inaxeon/dacattac/hardware/alpha/dacattac-alpha.xlsx

Qty | Reference(s) | Value | Footprint | Mouser part order number
34 | C1, C2, C3, C4, C5, C6, C7, C12, C13, C14, C15, C16, C17, C21, C22, C23, C43, C44, C45, C54, C57, C58, C59, C67, C71, C72, C73, C74, C75, C76, C77, C78, C87, C88 | 100n | Capacitor_SMD:C_0603_1608Metric
3 | C8, C37, C69 | NF | Capacitor_SMD:C_0603_1608Metric
3 | C9, C19, C33 | 82p | Capacitor_SMD:C_0603_1608Metric
7 | C10, C18, C20, C29, C30, C31, C40 | 100p | Capacitor_SMD:C_0603_1608Metric
3 | C11, C84, C85 | 33u | Capacitor_SMD:C_1210_3225Metric | C3225X5R1A336M200AC
2 | C24, C28 | 1n | Capacitor_SMD:C_0603_1608Metric
3 | C25, C39, C50 | 560p | Capacitor_SMD:C_0603_1608Metric
1 | C26 | 680p | Capacitor_SMD:C_0603_1608Metric
3 | C27, C51, C52 | 2n2 | Capacitor_SMD:C_0603_1608Metric
3 | C32, C36, C42 | 220p | Capacitor_SMD:C_0603_1608Metric
1 | C34 | 56p | Capacitor_SMD:C_0603_1608Metric
2 | C35, C47 | 390p | Capacitor_SMD:C_0603_1608Metric
1 | C38 | 270p | Capacitor_SMD:C_0603_1608Metric
1 | C41 | 18p | Capacitor_SMD:C_0603_1608Metric
1 | C46 | 47p | Capacitor_SMD:C_0603_1608Metric
1 | C48 | 4p7 | Capacitor_SMD:C_0603_1608Metric
1 | C49 | 2p-18p | BFC2808xxxxx:BFC2808xxxxx | BFC280811229
4 | C53, C56, C60, C61 | 2u2 | Capacitor_SMD:C_0603_1608Metric
1 | C55 | 10uF | Capacitor_SMD:C_1210_3225Metric | C3225X5R1E106K250AA
1 | C62 | 10n | Capacitor_SMD:C_0603_1608Metric
2 | C63, C68 | 10u | Capacitor_SMD:C_1210_3225Metric | C3225X7R1E106K250AC
1 | C64 | 4.7u | Capacitor_SMD:C_1210_3225Metric | C3225X7R1H475K250AB
1 | C65 | 4n7 | Capacitor_SMD:C_0603_1608Metric
1 | C66 | 220n | Capacitor_SMD:C_0603_1608Metric
1 | C70 | 180p | Capacitor_SMD:C_0603_1608Metric
1 | C79 | 22u | Capacitor_SMD:C_1210_3225Metric | C3225X7R1C226M250AC
2 | D1, D2 | MBR0540T1 | Diode_SMD:D_SOD-123 | MBR0540T1G
4 | D3, D4, D5, D6 | 1N4148 | Diode_SMD:D_SOD-123 | 1N4148W-7-F
1 | J1 | EXT POWER | Connector_Molex:Molex_KK-254_AE-6410-03A_1x03_P2.54mm_Vertical
2 | J2, J3 | OUT | MOLEX_73101:731010120 | 731010120
1 | J4 | AUDIO OUT | PJRAN2X1U01X:PJRAN2X1U01X | PJRAN2X1U01X
1 | J6 | I2C | Connector_Molex:Molex_KK-254_AE-6410-05A_1x05_P2.54mm_Vertical
6 | J10, J11, J12, J13, J14, J15 | HOLE | hackrf:GSG-HOLE126MIL-COPPER
1 | JP1 | TEST | Connector_PinHeader_2.54mm:PinHeader_1x03_P2.54mm_Vertical
6 | L5, L6, L17, L18, L21, L22 | 5u6 | Inductor_SMD:L_1210_3225Metric | 7440450056
1 | L7 | 9510 | NEOSID_7MM:NEOSID_7MM
1 | L8 | 9770 | NEOSID_7MM:NEOSID_7MM
2 | L9, L10 | 9760 | NEOSID_7MM:NEOSID_7MM
3 | L11, L12, L13 | 9750 | NEOSID_7MM:NEOSID_7MM
1 | L14 | 9500 | NEOSID_7MM:NEOSID_7MM
1 | L15 | 10u | Inductor_SMD:L_1210_3225Metric | 744045100
1 | L16 | 4u7 | Inductor_SMD:L_1210_3225Metric | 7440329004
1 | P20 | P20 | hackrf:GSG-HEADER-2x11
1 | P22 | P22 | hackrf:GSG-HEADER-2x13
1 | P28 | P28 | hackrf:GSG-HEADER-2x11
1 | P30 | BANK2_AUX | hackrf:GSG-HEADER-2x10
2 | Q1, Q2 | 2N7002 | Package_TO_SOT_SMD:SOT-23 | 2N7002
1 | Q3 | IRLML2244 | Package_TO_SOT_SMD:SOT-23 | IRLML2244TRPBF
2 | Q4, Q5 | BC857 | Package_TO_SOT_SMD:SOT-23 | BC857BS,135
1 | Q6 | BC807 | Package_TO_SOT_SMD:SOT-23 | BC807-40,215
2 | R1, R9 | 33 | Resistor_SMD:R_0603_1608Metric
1 | R2 | 3k9 | Resistor_SMD:R_0603_1608Metric
4 | R3, R52, R39, R32 | 10k | Resistor_SMD:R_0603_1608Metric
6 | R4, R13, R14, R15, R16, R28 | 100 | Resistor_SMD:R_0603_1608Metric
2 | R5, R25 | 3k3 | Resistor_SMD:R_0603_1608Metric
1 | R33 | 6k98 | Resistor_SMD:R_0603_1608Metric | RC0603FR-076K98L
1 | R45 | 10 | Resistor_SMD:R_0603_1608Metric
1 | R42 | 150k | Resistor_SMD:R_0603_1608Metric
1 | R41 | 988k | Resistor_SMD:R_0603_1608Metric | RN73H1JTTD9883F50
1 | R38 | 55k6 | Resistor_SMD:R_0603_1608Metric | TNPW060355K6BEEA
3 | R7, R11, R27 | 330 | Resistor_SMD:R_0603_1608Metric
4 | R8, R29, R30, R49 | 470 | Resistor_SMD:R_0603_1608Metric
3 | R10, R17, R51 | 75 | Resistor_SMD:R_0603_1608Metric
1 | R12 | 68 | Resistor_SMD:R_0603_1608Metric
3 | R6, R18, R36 | NF | Resistor_SMD:R_0603_1608Metric
1 | R19 | 1k8 | Resistor_SMD:R_0603_1608Metric
1 | R20 | 4k7 | Resistor_SMD:R_0603_1608Metric
2 | R21, R43 | 1k | Resistor_SMD:R_0603_1608Metric
3 | R22, R61, R62 | 2k2 | Resistor_SMD:R_0603_1608Metric
1 | R23 | 10 | Resistor_SMD:R_0603_1608Metric
1 | R24 | 270 | Resistor_SMD:R_0603_1608Metric
1 | R26 | 180 | Resistor_SMD:R_0603_1608Metric
1 | R31 | 220 | Resistor_SMD:R_0603_1608Metric
4 | R34, R35, R37, R46 | 0 | Resistor_SMD:R_0603_1608Metric
1 | R40 | 4k99 | Resistor_SMD:R_0603_1608Metric | RC0603FR-134K99L
1 | R44 | 1k5 | Resistor_SMD:R_0603_1608Metric
1 | R47 | 4k3 | Resistor_SMD:R_0603_1608Metric
1 | R48 | 47 | Resistor_SMD:R_0603_1608Metric
1 | R50 | 909 | Resistor_SMD:R_0603_1608Metric | RC0603FR-13909RL
1 | U1 | 74LVCH16T245 | Package_SO:TSSOP-48_6.1x12.5mm_P0.5mm | SN74LVCH16T245DGGR
1 | U2 | TPS61170DRVR | TPS61170DRVR:SON65P200X200X80-7N | TPS61170DRVR
1 | U3 | 74LVC1T45 | Package_TO_SOT_SMD:SOT-23-6 | SN74LVC1T45DBVT
1 | U4 | AD768 | Package_SO:SOIC-28W_7.5x18.7mm_P1.27mm | AD768ARZ
2 | U5, U7 | MAX4104 | Package_TO_SOT_SMD:SOT-23-5 | MAX4104EUK+T
1 | U6 | TLE2082 | Package_SO:SOIC-8_3.9x4.9mm_P1.27mm | TLE2082IDR
1 | U9 | PCM5102 | Package_SO:TSSOP-20_4.4x6.5mm_P0.65mm | PCM5102APW
1 | U10 | MCP1700T-3302E/MB | Package_TO_SOT_SMD:SOT-89-3 | MCP1700T-3302E/MB
1 | U11 | TPS63700DRCT | TPS63700DRCT:VREG_V62_16624-01YE | TPS63700DRCT
1 | U13 | L78L05_SO8 | Package_SO:SOIC-8_3.9x4.9mm_P1.27mm | L78L05ACD13TR
1 | U14 | L79L05_SO8 | Package_SO:SOIC-8_3.9x4.9mm_P1.27mm | L79L05ACD13TR
1 | U17 | MCP47FEB22A0-E/ST | Package_SO:TSSOP-8_4.4x3mm_P0.65mm | MCP47FEB22A0-E/ST
1 |  |  | HackRF One BANK2_AUX header
