inaxeon/dacattac/hardware/alpha/thirdparty-syms/TPS63700DRCT.step

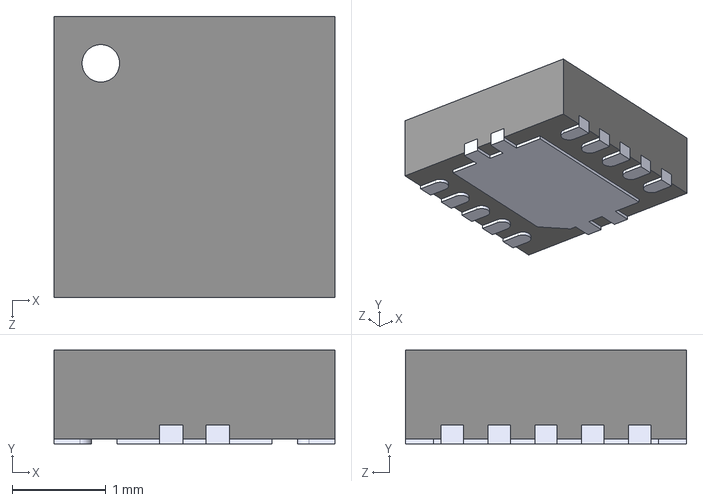
[picture p1: CAD file, 2024-06-18]
hardware/alpha/thirdparty-syms/TPS63700DRCT.step
3.00 x 1.00 x 3.00 mm
