inaxeon/dacattac/hardware/alpha/thirdparty-syms/TPS61170DRVR.step

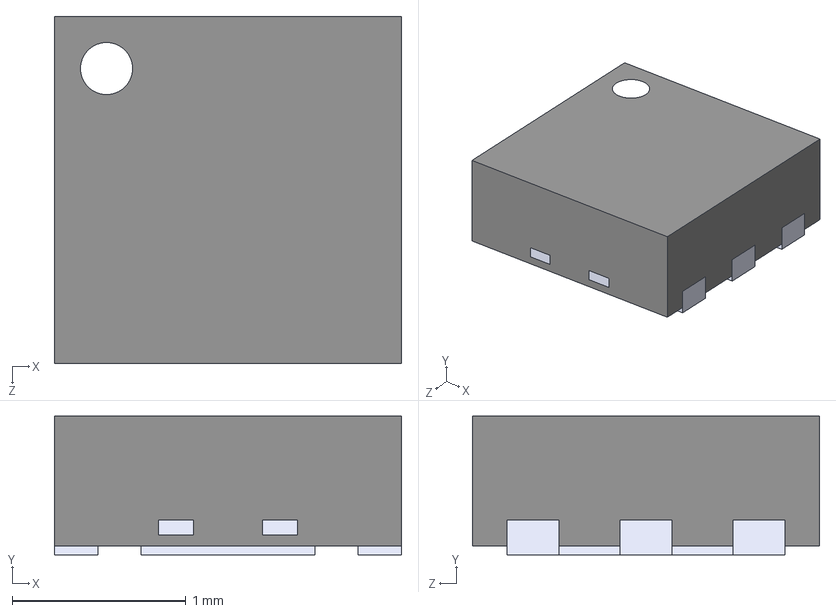
[picture p2: CAD file, 2024-06-13]
hardware/alpha/thirdparty-syms/TPS61170DRVR.step
2.00 x 0.8 x 2.00 mm
