inaxeon/dacattac/hardware/alpha/dacattac-alpha.kicad_pcb

## KiCad design hardware/alpha/dacattac-alpha.kicad_pcb (2024-10-24)

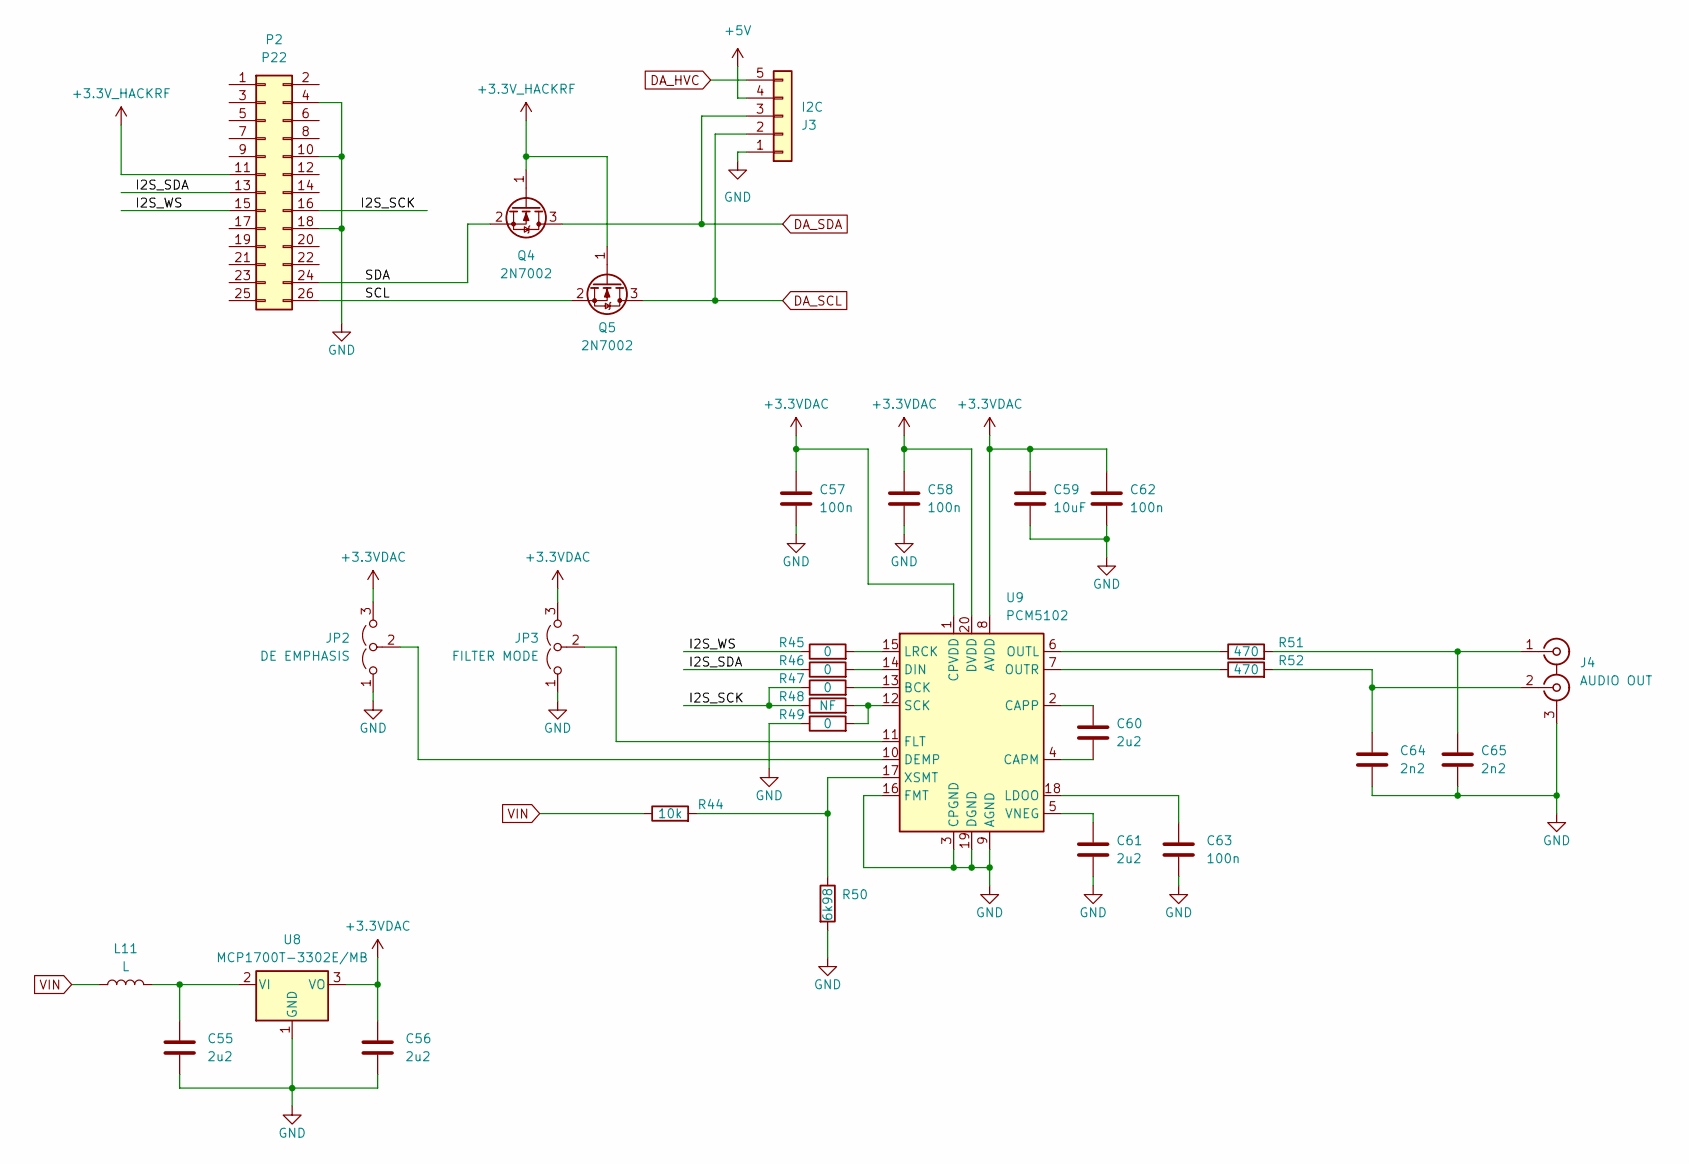
[picture p3: schematic audio.kicad_sch, ${TITLE}]

Parts:
C55, C56, C60, C61: 2u2; C_0603_1608Metric
C57, C58, C62, C63: 100n; C_0603_1608Metric
C59: 10uF; C_1210_3225Metric
C64, C65: 2n2; C_0603_1608Metric
J3: I2C; Molex_KK-254_AE-6410-05A_1x05_P2.54mm_Vertical
J4: AUDIO OUT; PJRAN2X1U01X
JP2: DE EMPHASIS; SolderJumper-3_P1.3mm_Open_Pad1.0x1.5mm
JP3: FILTER MODE; SolderJumper-3_P1.3mm_Open_Pad1.0x1.5mm
L11: L; L_1210_3225Metric
P2: P22; GSG-HEADER-2x13
Q4, Q5: 2N7002; SOT-23
R44: 10k; R_0603_1608Metric
R45, R46, R47, R49: 0; R_0603_1608Metric
R48: NF; R_0603_1608Metric
R50: 6k98; R_0603_1608Metric
R51, R52: 470; R_0603_1608Metric
U8: MCP1700T-3302E/MB; SOT-89-3
U9: PCM5102; TSSOP-20_4.4x6.5mm_P0.65mm

Connections:
+3.3VDAC: C56.1, C57.1, C58.1, C59.1, C62.1, JP2.3 (B), JP3.3 (B), U8.3 (VO), U9.1 (CPVDD), U9.8 (AVDD), U9.20 (DVDD)
+3.3V_HACKRF: P2.11, Q4.1 (G), Q5.1 (G); also elsewhere on the board
+5V: J3.4; also elsewhere on the board
/audio/I2S_SCK: P2.16, R47.1, R48.1
/audio/I2S_SDA: P2.13, R46.1
/audio/I2S_WS: P2.15, R45.1
/audio/SCL: P2.26, Q5.2 (S)
/audio/SDA: P2.24, Q4.2 (S)
DA_HVC: J3.5; also elsewhere on the board
DA_SCL: J3.2, Q5.3 (D); also elsewhere on the board
DA_SDA: J3.3, Q4.3 (D); also elsewhere on the board
GND: C55.2, C56.2, C57.2, C58.2, C59.2, C61.2, C62.2, C63.2, C64.2, C65.2, J3.1, J4.3 (EXT), JP2.1 (A), JP3.1 (A), P2.4, P2.10, P2.18, R49.1, R50.2, U8.1 (GND), U9.3 (CPGND), U9.9 (AGND), U9.16 (FMT), U9.19 (DGND); also elsewhere on the board
unnamed: C65.1, J4.1 (IN1), R51.2
unnamed: C64.1, J4.2 (IN2), R52.2
unnamed: JP2.2 (C), U9.10 (DEMP)
unnamed: JP3.2 (C), U9.11 (FLT)
unnamed: C55.1, L11.2, U8.2 (VI)
unnamed: R47.2, U9.13 (BCK)
unnamed: C60.2, U9.4 (CAPM)
unnamed: C60.1, U9.2 (CAPP)
unnamed: R46.2, U9.14 (DIN)
unnamed: C63.1, U9.18 (LDOO)
unnamed: R45.2, U9.15 (LRCK)
unnamed: R51.1, U9.6 (OUTL)
unnamed: R52.1, U9.7 (OUTR)
unnamed: R48.2, R49.2, U9.12 (SCK)
unnamed: C61.1, U9.5 (VNEG)
unnamed: R44.2, R50.1, U9.17 (XSMT)
VIN: L11.1, R44.1; also elsewhere on the board

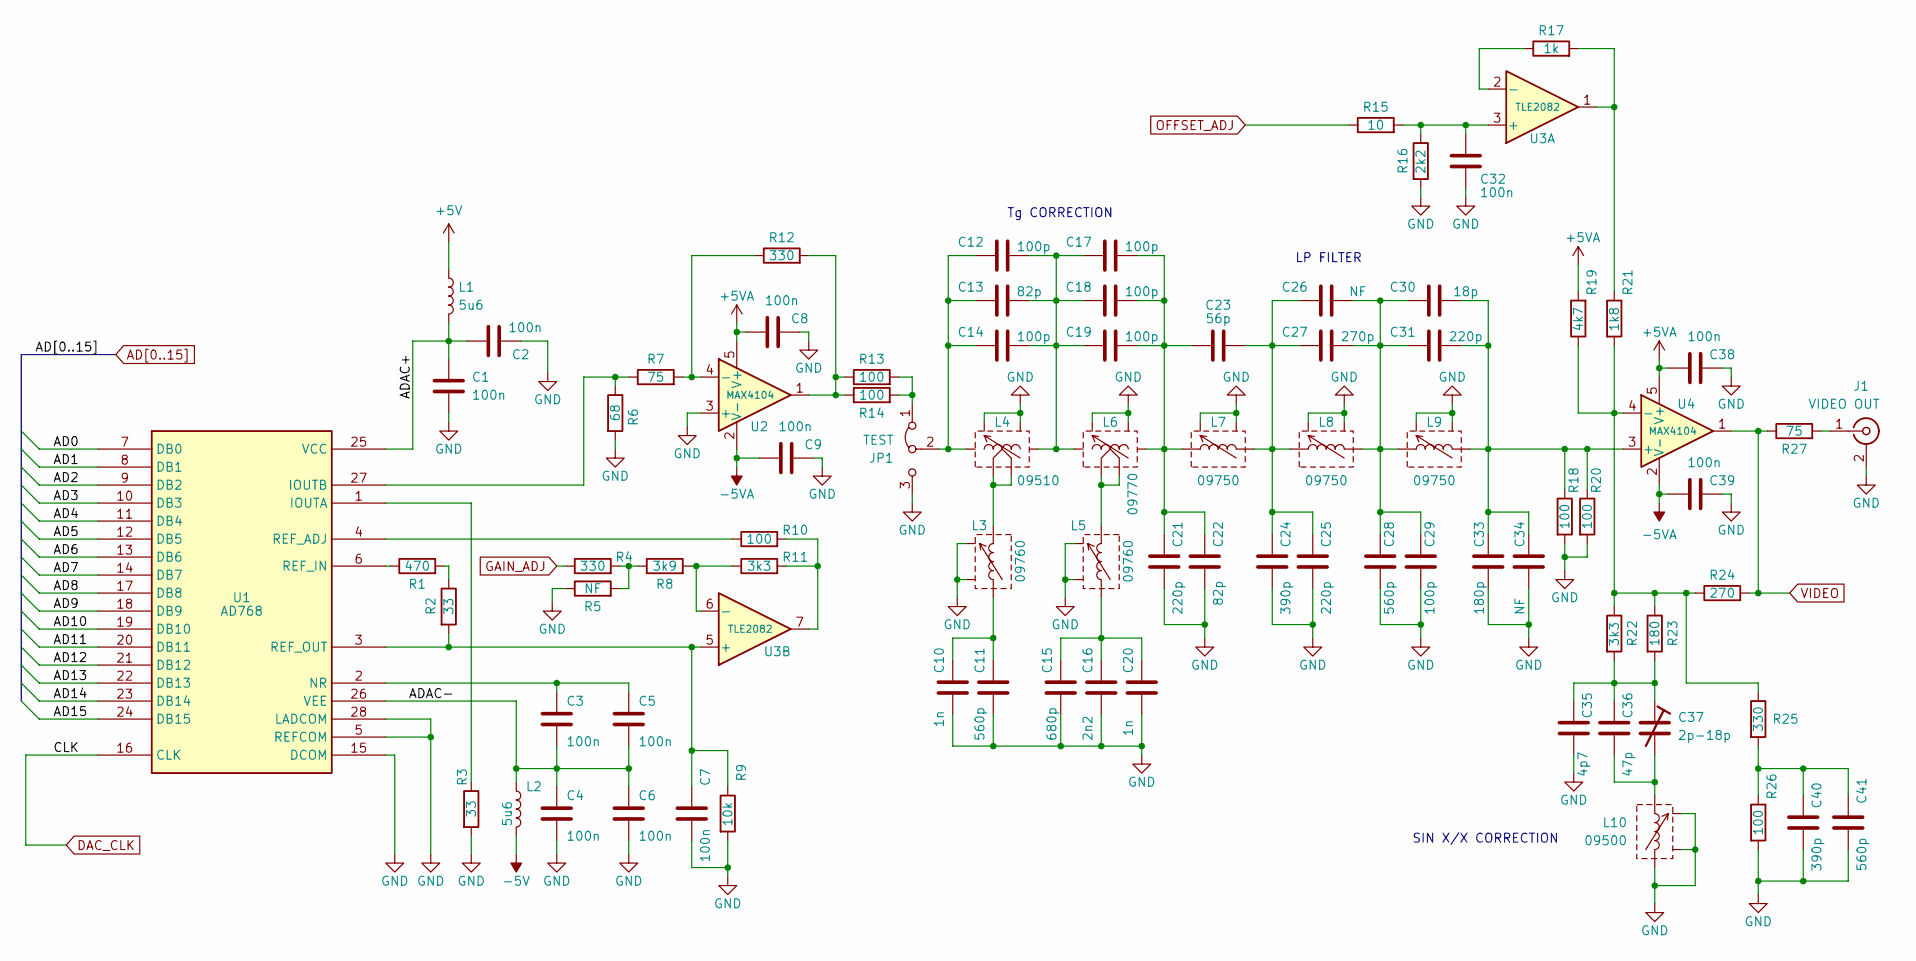
[picture p4: schematic video.kicad_sch, ${TITLE}]

Parts:
C1, C2, C3, C4, C5, C6, C7, C8, C9, C32, C38, C39: 100n; C_0603_1608Metric
C10, C20: 1n; C_0603_1608Metric
C11, C28, C41: 560p; C_0603_1608Metric
C12, C14, C17, C18, C19, C29: 100p; C_0603_1608Metric
C13, C22: 82p; C_0603_1608Metric
C15: 680p; C_0603_1608Metric
C16: 2n2; C_0603_1608Metric
C21, C25, C31: 220p; C_0603_1608Metric
C23: 56p; C_0603_1608Metric
C24, C40: 390p; C_0603_1608Metric
C26, C34: NF; C_0603_1608Metric
C27: 270p; C_0603_1608Metric
C30: 18p; C_0603_1608Metric
C33: 180p; C_0603_1608Metric
C35: 4p7; C_0603_1608Metric
C36: 47p; C_0603_1608Metric
C37: 2p-18p; BFC2808xxxxx
J1: VIDEO OUT; 731010120
JP1: TEST; PinHeader_1x03_P2.54mm_Vertical
L1, L2: 5u6; L_1210_3225Metric
L3, L5: 09760; NEOSID_7MM
L4: 09510; NEOSID_7MM
L6: 09770; NEOSID_7MM
L7, L8, L9: 09750; NEOSID_7MM
L10: 09500; NEOSID_7MM
R1: 470; R_0603_1608Metric
R2, R3: 33; R_0603_1608Metric
R4, R12, R25: 330; R_0603_1608Metric
R5: NF; R_0603_1608Metric
R6: 68; R_0603_1608Metric
R7, R27: 75; R_0603_1608Metric
R8: 3k9; R_0603_1608Metric
R9: 10k; R_0603_1608Metric
R10, R13, R14, R18, R20, R26: 100; R_0603_1608Metric
R11, R22: 3k3; R_0603_1608Metric
R15: 10; R_0603_1608Metric
R16: 2k2; R_0603_1608Metric
R17: 1k; R_0603_1608Metric
R19: 4k7; R_0603_1608Metric
R21: 1k8; R_0603_1608Metric
R23: 180; R_0603_1608Metric
R24: 270; R_0603_1608Metric
U1: AD768; SOIC-28W_7.5x18.7mm_P1.27mm
U2, U4: MAX4104; SOT-23-5
U3: TLE2082; SOIC-8_3.9x4.9mm_P1.27mm

Connections:
+5V: L1.1; also elsewhere on the board
+5VA: C8.1, C38.1, R19.2, U2.5 (V+), U4.5 (V+); also elsewhere on the board
-5V: L2.2; also elsewhere on the board
-5VA: C9.1, C39.1, U2.2 (V-), U4.2 (V-); also elsewhere on the board
/video/ADAC+: C1.2, C2.2, L1.2, U1.25 (VCC)
/video/ADAC-: C3.2, C4.1, C5.1, C6.1, L2.1, U1.26 (VEE)
AD0: U1.7 (DB0); also elsewhere on the board
AD1: U1.8 (DB1); also elsewhere on the board
AD2: U1.9 (DB2); also elsewhere on the board
AD3: U1.10 (DB3); also elsewhere on the board
AD4: U1.11 (DB4); also elsewhere on the board
AD5: U1.12 (DB5); also elsewhere on the board
AD6: U1.13 (DB6); also elsewhere on the board
AD7: U1.14 (DB7); also elsewhere on the board
AD8: U1.17 (DB8); also elsewhere on the board
AD9: U1.18 (DB9); also elsewhere on the board
AD10: U1.19 (DB10); also elsewhere on the board
AD11: U1.20 (DB11); also elsewhere on the board
AD12: U1.21 (DB12); also elsewhere on the board
AD13: U1.22 (DB13); also elsewhere on the board
AD14: U1.23 (DB14); also elsewhere on the board
AD15: U1.24 (DB15); also elsewhere on the board
DAC_CLK: U1.16 (CLK); also elsewhere on the board
GAIN_ADJ: R4.1; also elsewhere on the board
GND: C1.1, C2.1, C4.2, C6.2, C7.2, C8.2, C9.2, C10.2, C11.2, C15.2, C16.2, C20.2, C21.2, C22.2, C24.2, C25.2, C28.2, C29.2, C32.2, C33.2, C34.2, C35.2, C38.2, C39.2, C40.2, C41.2, J1.2 (Ext), JP1.3 (B), L3.6, L4.6, L5.6, L6.6, L7.6, L8.6, L9.6, L10.4, L10.6, R3.2, R5.1, R6.2, R9.2, R16.2, R18.2, R20.2, R26.2, U1.5 (REFCOM), U1.15 (DCOM), U1.28 (LADCOM), U2.3 (+); also elsewhere on the board
unnamed: C10.1, C11.1, L3.4
unnamed: C12.2, C13.2, C14.2, C17.1, C18.1, C19.1, L4.1, L6.5
unnamed: C15.1, C16.1, C20.1, L5.4
unnamed: C17.2, C18.2, C19.2, C21.1, C22.1, C23.1, L6.1, L7.1
unnamed: C23.2, C24.1, C25.1, C26.1, C27.1, L7.4, L8.1
unnamed: C26.2, C27.2, C28.1, C29.1, C30.1, C31.1, L8.4, L9.1
unnamed: C35.1, C36.1, C37.1, R22.2, R23.2
unnamed: C36.2, C37.2, L10.1
unnamed: C40.1, C41.1, R25.2, R26.1
unnamed: J1.1 (In), R27.2
unnamed: JP1.1 (A), R13.2, R14.2
unnamed: C12.1, C13.1, C14.1, JP1.2 (C), L4.5
unnamed: L3.1, L4.2, L4.4
unnamed: L5.1, L6.2, L6.4
unnamed: R1.2, R2.1
unnamed: R4.2, R5.2, R8.1
unnamed: R10.2, R11.2, U3.7
unnamed: R12.2, R13.1, R14.1, U2.1
unnamed: R17.2, R21.1, U3.1
unnamed: R3.1, U1.1 (IOUTA)
unnamed: R6.1, R7.1, U1.27 (IOUTB)
unnamed: C3.1, C5.2, U1.2 (NR)
unnamed: R10.1, U1.4 (REF_ADJ)
unnamed: R1.1, U1.6 (REF_IN)
unnamed: C7.1, R2.2, R9.1, U1.3 (REF_OUT), U3.5 (+)
unnamed: R7.2, R12.1, U2.4 (-)
unnamed: C32.1, R15.2, R16.1, U3.3 (+)
unnamed: R17.1, U3.2 (-)
unnamed: R8.2, R11.1, U3.6 (-)
unnamed: C30.2, C31.2, C33.1, C34.1, L9.4, R18.1, R20.1, U4.3 (+)
unnamed: R19.1, R21.2, R22.1, R23.1, R24.1, R25.1, U4.4 (-)
OFFSET_ADJ: R15.1; also elsewhere on the board
VIDEO: R24.2, R27.1, U4.1; also elsewhere on the board

Notes on the sheet:
LP FILTER
Tg CORRECTION
SIN X/X CORRECTION

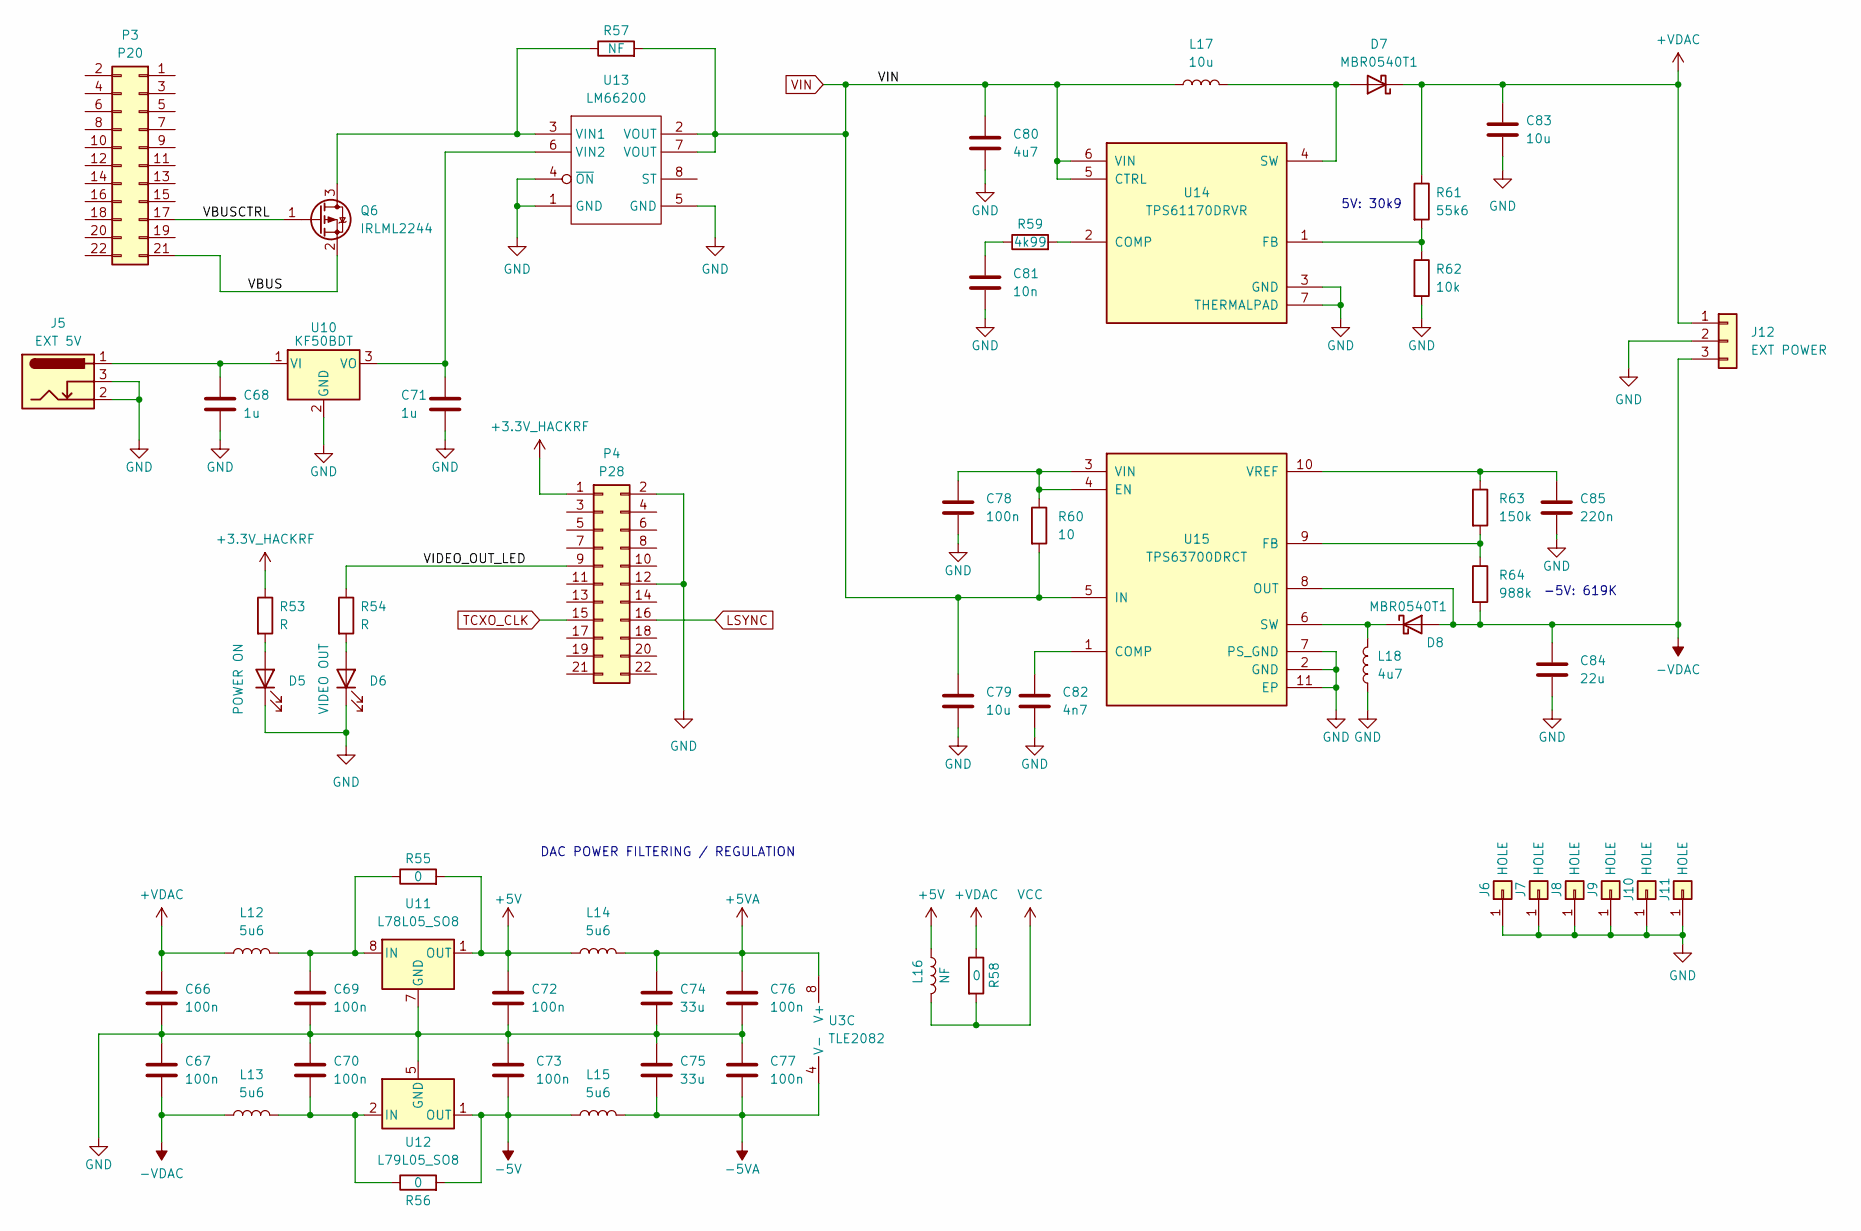
[picture p5: schematic power.kicad_sch, ${TITLE}]

Parts:
C66, C67, C69, C70, C72, C73, C76, C77, C78: 100n; C_0603_1608Metric
C68, C71: 1u; C_0603_1608Metric
C74, C75: 33u; C_1210_3225Metric
C79, C83: 10u; C_1210_3225Metric
C80: 4u7; C_1210_3225Metric
C81: 10n; C_0603_1608Metric
C82: 4n7; C_0603_1608Metric
C84: 22u; C_1210_3225Metric
C85: 220n; C_0603_1608Metric
D5: POWER ON; LED_0805_2012Metric
D6: VIDEO OUT; LED_0805_2012Metric
D7, D8: MBR0540T1; D_SOD-123
J5: EXT 5V; BarrelJack_Horizontal
J6, J7, J8, J9, J10, J11: HOLE; GSG-HOLE126MIL-COPPER
J12: EXT POWER; Molex_KK-254_AE-6410-03A_1x03_P2.54mm_Vertical
L12, L13, L14, L15: 5u6; L_1210_3225Metric
L16: NF; L_1210_3225Metric
L17: 10u; L_1210_3225Metric
L18: 4u7; L_1210_3225Metric
P3: P20; GSG-HEADER-2x11
P4: P28; GSG-HEADER-2x11
Q6: IRLML2244; SOT-23
R53, R54: R; R_0603_1608Metric
R55, R56, R58: 0; R_0603_1608Metric
R57: NF; R_0603_1608Metric
R59: 4k99; R_0603_1608Metric
R60: 10; R_0603_1608Metric
R61: 55k6; R_0603_1608Metric
R62: 10k; R_0603_1608Metric
R63: 150k; R_0603_1608Metric
R64: 988k; R_0603_1608Metric
U3: TLE2082; SOIC-8_3.9x4.9mm_P1.27mm
U10: KF50BDT; TO-252-2
U11: L78L05_SO8; SOIC-8_3.9x4.9mm_P1.27mm
U12: L79L05_SO8; SOIC-8_3.9x4.9mm_P1.27mm
U13: LM66200; SOT-583-8
U14: TPS61170DRVR; SON65P200X200X80-7N
U15: TPS63700DRCT; VREG_V62_16624-01YE

Connections:
+3.3V_HACKRF: P4.1, R53.1; also elsewhere on the board
+5V: C72.1, L14.1, L16.1, R55.2, U11.1 (OUT); also elsewhere on the board
+5VA: C74.1, C76.1, L14.2, U3.8 (V+); also elsewhere on the board
+VDAC: C66.1, C83.1, D7.1 (K), J12.1, L12.1, R58.1, R61.1
-5V: C73.2, L15.1, R56.2, U12.1 (OUT); also elsewhere on the board
-5VA: C75.2, C77.2, L15.2, U3.4 (V-); also elsewhere on the board
-VDAC: C67.2, C84.1, D8.2 (A), J12.3, L13.1, R64.2, U15.8 (OUT); also elsewhere on the board
/power/VBUS: P3.21, Q6.2 (S)
/power/VBUSCTRL: P3.17, Q6.1 (G)
/power/VIDEO_OUT_LED: P4.9, R54.1
GND: C66.2, C67.1, C68.2, C69.2, C70.1, C71.2, C72.2, C73.1, C74.2, C75.1, C76.2, C77.1, C78.2, C79.2, C80.2, C81.2, C82.2, C83.2, C84.2, C85.2, D5.1 (K), D6.1 (K), J5.2, J5.3, J6.1, J7.1, J8.1, J9.1, J10.1, J11.1, J12.2, L18.1, P4.2, P4.12, R62.2, U10.2 (GND), U11.2 (GND), U11.3 (GND), U11.6 (GND), U11.7 (GND), U12.5 (GND), U13.1 (GND), U13.4 (~ON), U13.5 (GND), U14.3 (GND), U14.7 (THERMALPAD), U15.2 (GND), U15.7 (PS_GND), U15.11 (EP); also elsewhere on the board
LSYNC: P4.16; also elsewhere on the board
unnamed: C70.2, L13.2, R56.1, U12.2 (IN), U12.3 (IN), U12.6 (IN), U12.7 (IN)
unnamed: C81.1, R59.1
unnamed: D5.2 (A), R53.2
unnamed: D6.2 (A), R54.2
unnamed: D7.2 (A), L17.2, U14.4 (SW)
unnamed: D8.1 (K), L18.2, U15.6 (SW)
unnamed: Q6.3 (D), R57.1, U13.3 (VIN1)
unnamed: C68.1, J5.1, U10.1 (VI)
unnamed: C71.1, U10.3 (VO), U13.6 (VIN2)
unnamed: C69.1, L12.2, R55.1, U11.8 (IN)
unnamed: R59.2, U14.2 (COMP)
unnamed: R61.2, R62.1, U14.1 (FB)
unnamed: C82.1, U15.1 (COMP)
unnamed: C78.1, R60.1, U15.3 (VIN), U15.4 (EN)
unnamed: R63.2, R64.1, U15.9 (FB)
unnamed: C85.1, R63.1, U15.10 (VREF)
TCXO_CLK: P4.15; also elsewhere on the board
VCC: L16.2, R58.2; also elsewhere on the board
VIN: C79.1, C80.1, L17.1, R57.2, R60.2, U13.2 (VOUT), U13.7 (VOUT), U14.5 (CTRL), U14.6 (VIN), U15.5 (IN); also elsewhere on the board

Notes on the sheet:
DAC POWER FILTERING / REGULATION
-5V: 619K
5V: 30k9

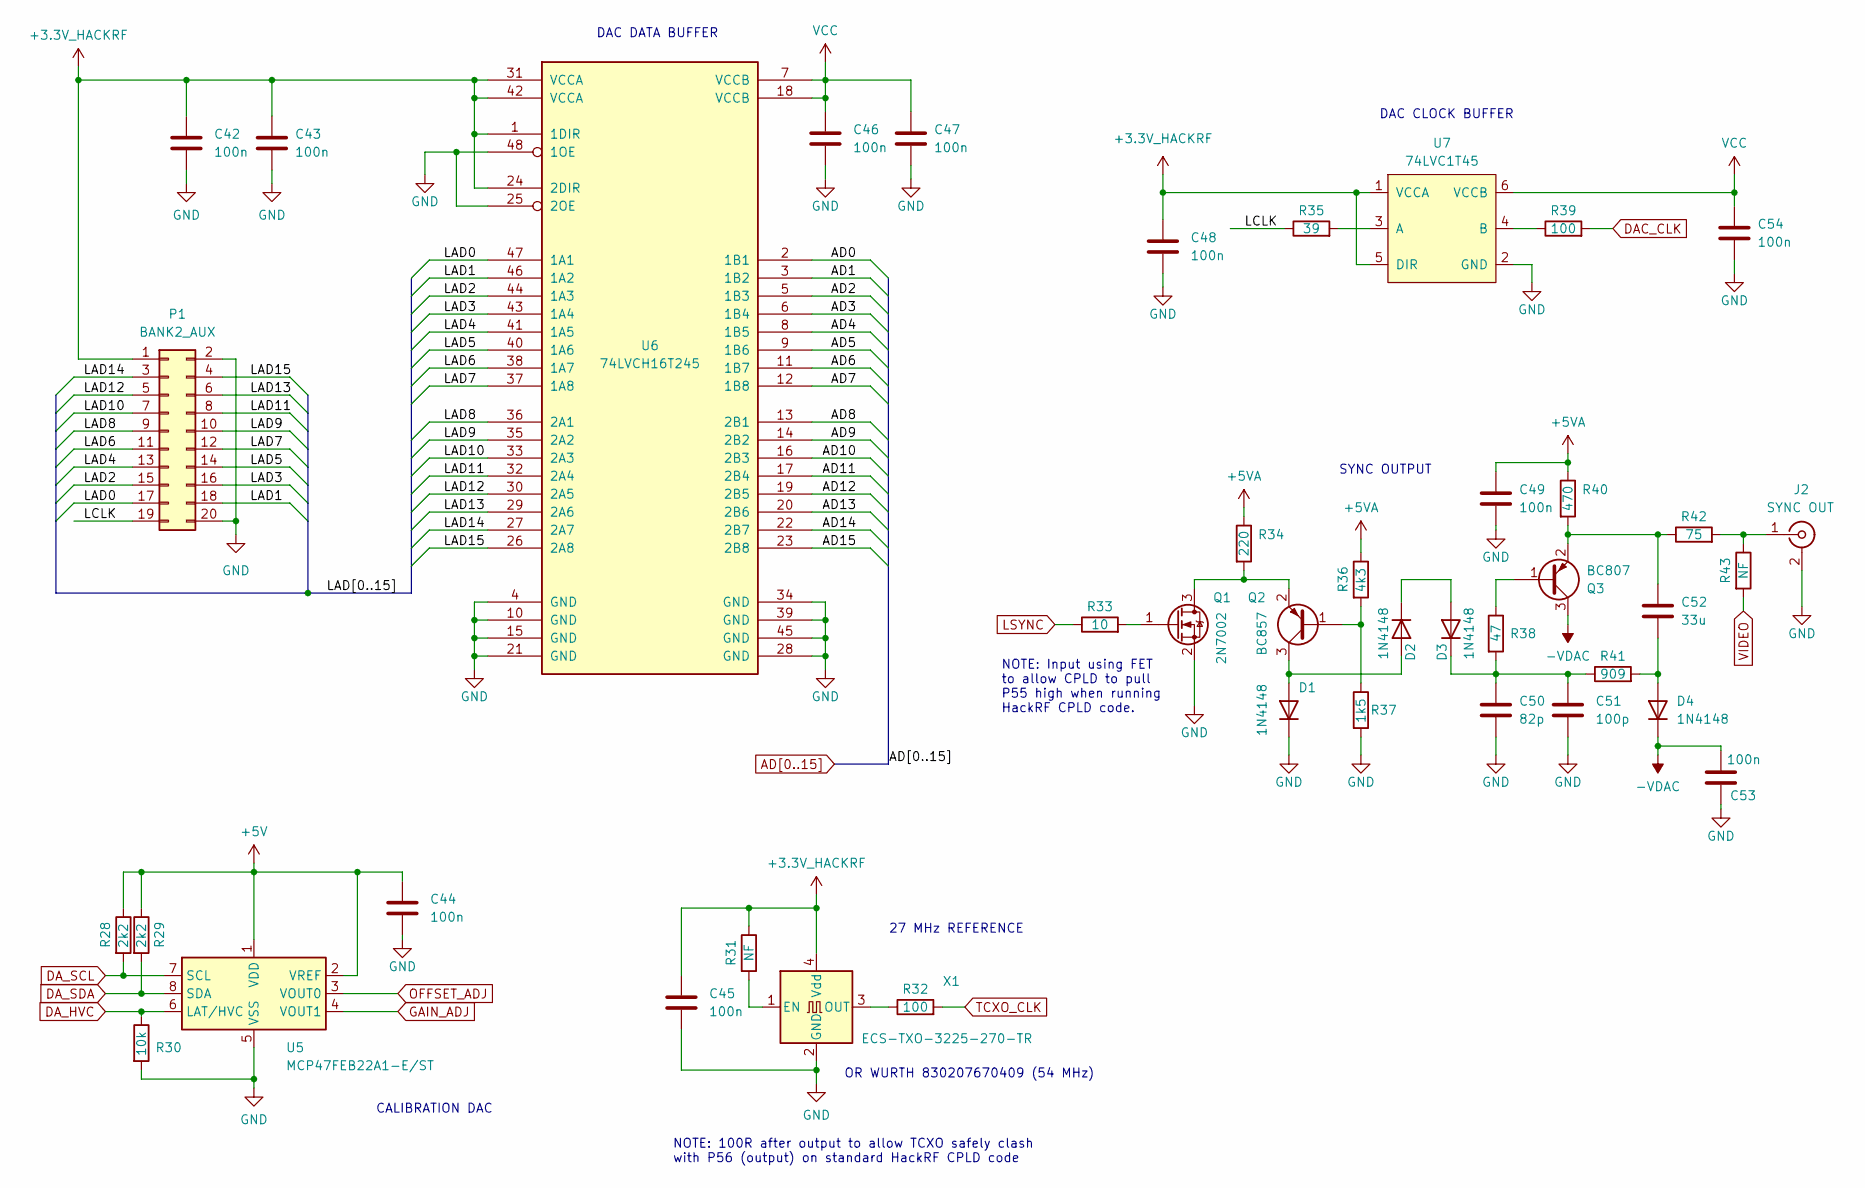
[picture p6: schematic video-misc.kicad_sch, ${TITLE}]

Parts:
C42, C43, C44, C45, C46, C47, C48, C49, C53, C54: 100n; C_0603_1608Metric
C50: 82p; C_0603_1608Metric
C51: 100p; C_0603_1608Metric
C52: 33u; C_1210_3225Metric
D1, D2, D3, D4: 1N4148; D_SOD-123
J2: SYNC OUT; 731010120
P1: BANK2_AUX; GSG-HEADER-2x10
Q1: 2N7002; SOT-23
Q2: BC857; SOT-23
Q3: BC807; SOT-23
R28, R29: 2k2; R_0603_1608Metric
R30: 10k; R_0603_1608Metric
R31, R43: NF; R_0603_1608Metric
R32, R39: 100; R_0603_1608Metric
R33: 10; R_0603_1608Metric
R34: 220; R_0603_1608Metric
R35: 39; R_0603_1608Metric
R36: 4k3; R_0603_1608Metric
R37: 1k5; R_0603_1608Metric
R38: 47; R_0603_1608Metric
R40: 470; R_0603_1608Metric
R41: 909; R_0603_1608Metric
R42: 75; R_0603_1608Metric
U5: MCP47FEB22A1-E/ST; TSSOP-8_4.4x3mm_P0.65mm
U6: 74LVCH16T245; TSSOP-48_6.1x12.5mm_P0.5mm
U7: 74LVC1T45; SOT-23-6
X1: ECS-TXO-3225-270-TR; Oscillator_SMD_EuroQuartz_XO32-4Pin_3.2x2.5mm

Connections:
+3.3V_HACKRF: C42.1, C43.1, C45.1, C48.1, P1.1, R31.1, U6.1 (1DIR), U6.24 (2DIR), U6.31 (VCCA), U6.42 (VCCA), U7.1 (VCCA), U7.5 (DIR), X1.4 (Vdd); also elsewhere on the board
+5V: C44.1, R28.1, R29.1, U5.1 (VDD), U5.2 (VREF); also elsewhere on the board
+5VA: C49.1, R34.1, R36.1, R40.1; also elsewhere on the board
-VDAC: C53.2, D4.1 (K), Q3.3 (C); also elsewhere on the board
/video-misc/LAD0: P1.17, U6.47 (1A1)
/video-misc/LAD1: P1.18, U6.46 (1A2)
/video-misc/LAD2: P1.15, U6.44 (1A3)
/video-misc/LAD3: P1.16, U6.43 (1A4)
/video-misc/LAD4: P1.13, U6.41 (1A5)
/video-misc/LAD5: P1.14, U6.40 (1A6)
/video-misc/LAD6: P1.11, U6.38 (1A7)
/video-misc/LAD7: P1.12, U6.37 (1A8)
/video-misc/LAD8: P1.9, U6.36 (2A1)
/video-misc/LAD9: P1.10, U6.35 (2A2)
/video-misc/LAD10: P1.7, U6.33 (2A3)
/video-misc/LAD11: P1.8, U6.32 (2A4)
/video-misc/LAD12: P1.5, U6.30 (2A5)
/video-misc/LAD13: P1.6, U6.29 (2A6)
/video-misc/LAD14: P1.3, U6.27 (2A7)
/video-misc/LAD15: P1.4, U6.26 (2A8)
/video-misc/LCLK: P1.19, R35.1
AD0: U6.2 (1B1); also elsewhere on the board
AD1: U6.3 (1B2); also elsewhere on the board
AD2: U6.5 (1B3); also elsewhere on the board
AD3: U6.6 (1B4); also elsewhere on the board
AD4: U6.8 (1B5); also elsewhere on the board
AD5: U6.9 (1B6); also elsewhere on the board
AD6: U6.11 (1B7); also elsewhere on the board
AD7: U6.12 (1B8); also elsewhere on the board
AD8: U6.13 (2B1); also elsewhere on the board
AD9: U6.14 (2B2); also elsewhere on the board
AD10: U6.16 (2B3); also elsewhere on the board
AD11: U6.17 (2B4); also elsewhere on the board
AD12: U6.19 (2B5); also elsewhere on the board
AD13: U6.20 (2B6); also elsewhere on the board
AD14: U6.22 (2B7); also elsewhere on the board
AD15: U6.23 (2B8); also elsewhere on the board
DAC_CLK: R39.2; also elsewhere on the board
DA_HVC: R30.1, U5.6 (LAT/HVC); also elsewhere on the board
DA_SCL: R28.2, U5.7 (SCL); also elsewhere on the board
DA_SDA: R29.2, U5.8 (SDA); also elsewhere on the board
GAIN_ADJ: U5.4 (VOUT1); also elsewhere on the board
GND: C42.2, C43.2, C44.2, C45.2, C46.2, C47.2, C48.2, C49.2, C50.2, C51.2, C53.1, C54.2, D1.1 (K), J2.2 (Ext), P1.2, P1.20, Q1.2 (S), R30.2, R37.2, U5.5 (VSS), U6.4 (GND), U6.10 (GND), U6.15 (GND), U6.21 (GND), U6.25 (2OE), U6.28 (GND), U6.34 (GND), U6.39 (GND), U6.45 (GND), U6.48 (1OE), U7.2 (GND), X1.2 (GND); also elsewhere on the board
LSYNC: R33.1; also elsewhere on the board
unnamed: D1.2 (A), D2.2 (A), Q2.3 (C)
unnamed: D2.1 (K), D3.2 (A)
unnamed: C50.1, C51.1, D3.1 (K), R38.2, R41.1
unnamed: C52.2, D4.2 (A), R41.2
unnamed: J2.1 (In), R42.2, R43.1
unnamed: Q1.3 (D), Q2.2 (E), R34.2
unnamed: Q1.1 (G), R33.2
unnamed: Q2.1 (B), R36.2, R37.1
unnamed: Q3.1 (B), R38.1
unnamed: C52.1, Q3.2 (E), R40.2, R42.1
unnamed: R35.2, U7.3 (A)
unnamed: R39.1, U7.4 (B)
unnamed: R31.2, X1.1 (EN)
unnamed: R32.1, X1.3 (OUT)
OFFSET_ADJ: U5.3 (VOUT0); also elsewhere on the board
TCXO_CLK: R32.2; also elsewhere on the board
VCC: C46.1, C47.1, C54.1, U6.7 (VCCB), U6.18 (VCCB), U7.6 (VCCB); also elsewhere on the board
VIDEO: R43.2; also elsewhere on the board

Notes on the sheet:
CALIBRATION DAC
DAC DATA BUFFER
NOTE: Input using FET to allow CPLD to pull P55 high when running HackRF CPLD code.
OR WURTH 830207670409 (54 MHz)
27 MHz REFERENCE
NOTE: 100R after output to allow TCXO safely clash with P56 (output) on standard HackRF CPLD code
DAC CLOCK BUFFER
SYNC OUTPUT

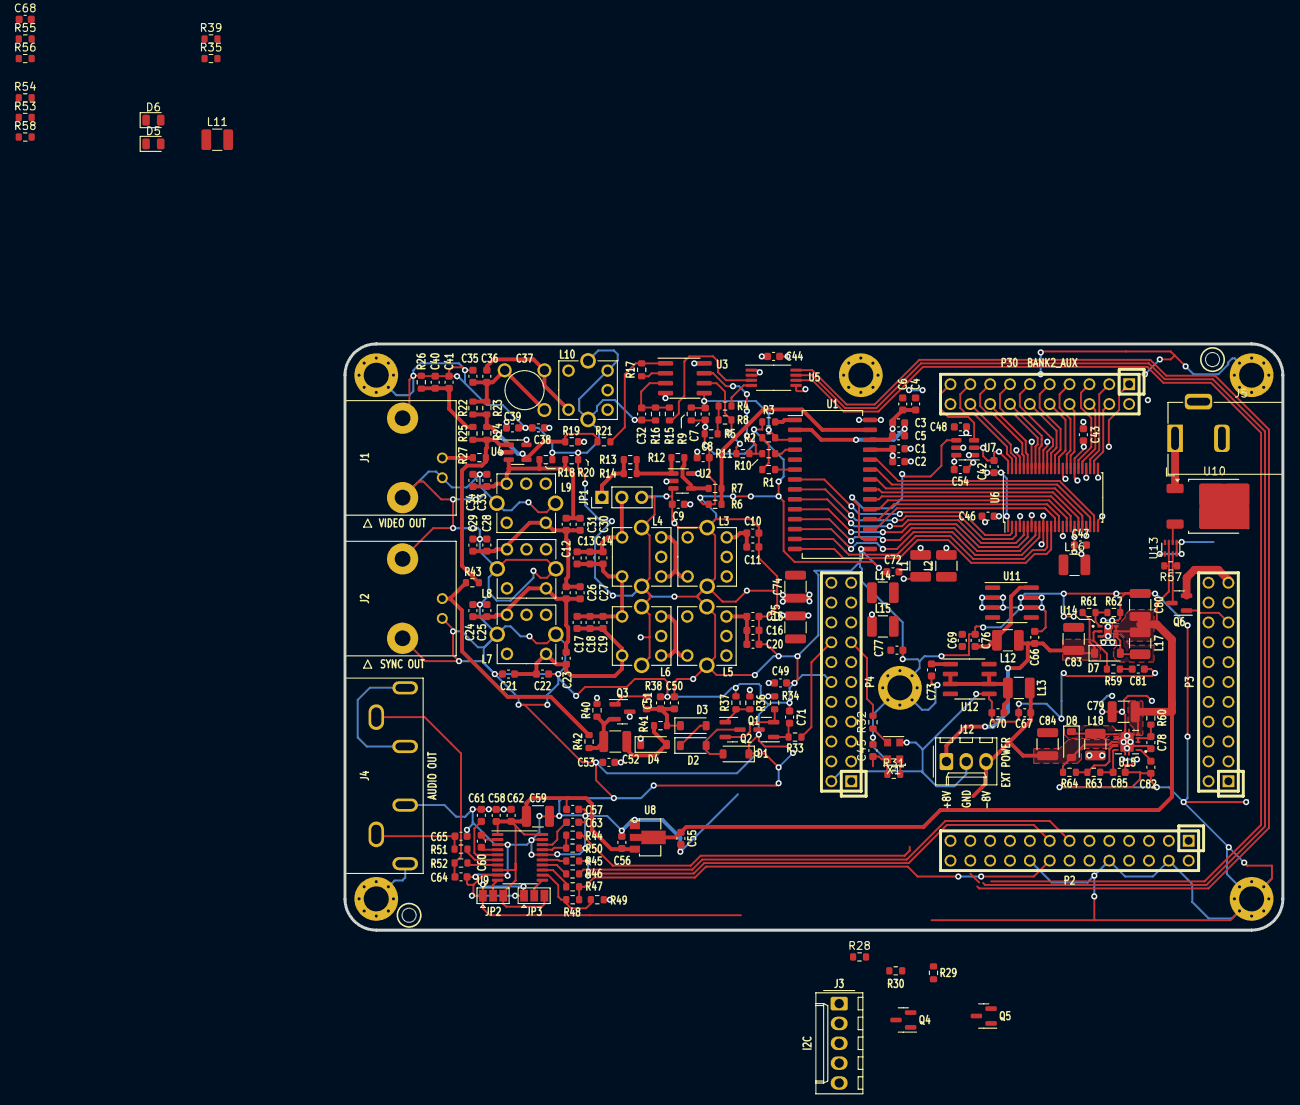
[picture p7: board dacattac-alpha.kicad_pcb from above]

Board: 4 copper layers, 120.0 x 75.0 mm, 218 parts (0 on the bottom side), 140 nets.

Other parts of the board:
FID1, FID2: FIDUCIAL; GSG-MARK1MM
