inaxeon/dacattac/(commit log)

2024-06-13 Add project
    [TPS61170DRVR.step, audio.kicad_sch, dacattac-alpha.kicad_pcb, dacattac-alpha.kicad_sch, power.kicad_sch, video.kicad_sch]
2024-07-29 Added / updated BOm
    [audio.kicad_sch, dacattac-alpha.xlsx, power.kicad_sch, video-misc.kicad_sch, video.kicad_sch]
2024-07-29 BOM WIP
    [dacattac-alpha.xlsx, power.kicad_sch]
