inaxeon/dacattac/(notices)

Notices in the files:
parts and their libraries:
COPYRIGHT: Copyright 2024 Matt Millman
LICENSE: Licensed under the CERN-OHL-P v2
